zTrix/cpu20day/trunk/doc/IF.pdf

F

clk

rst

stall

i_instruction(15:0) o_instruction(15:0)
