zTrix/cpu20day/trunk/doc/schematic.pdf

1

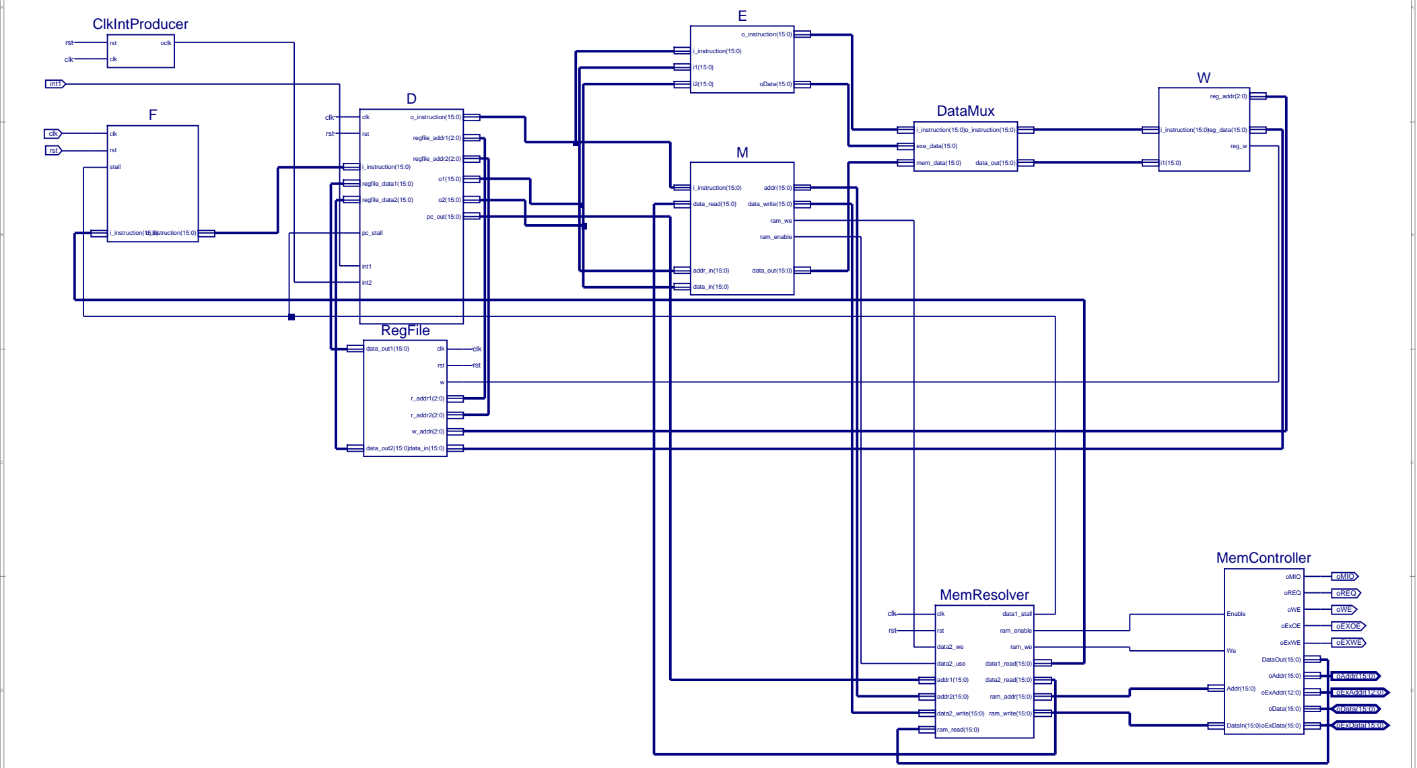
[picture p8: figure]
clk; RegFile; rst; r_addr1(2:0); r_addr2(2:0); w_addr(2:0); data_in(15:0); data_out1(15:0); data_out2(15:0); MemController; Enable; Addr(15:0); DataIn(15:0); oData(15:0); oExData(15:0); oMIO; oREQ; oWE; oExOE; oExWE; DataOut(15:0); oAddr(15:0); oExAddr(12:0); oEXOE; oEXWE; MemResolver; data2_we; data2_use; addr1(15:0); addr2(15:0); data2_write(15:0); ram_read(15:0); data1_stall; ram_enable; ram_we; data1_read(15:0); data2_read(15:0); ram_addr(15:0); ram_write(15:0); i_instruction(15:0); o_instruction(15:0); addr_in(15:0); data_read(15:0); data_out(15:0); addr(15:0); data_write(15:0); DataMux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
# DebugOutput

input1(15:0)

input2(15:0)

input3(15:0)

output1(15:0)

output2(15:0)

output3(15:0)

Debug1(15:0)

Debug2(15:0)

Debug3(15:0)

id_instr(15:0)

id_o1(15:0)

id_o2(15:0)
