zTrix/cpu20day/trunk/doc/clkintproducer.pdf

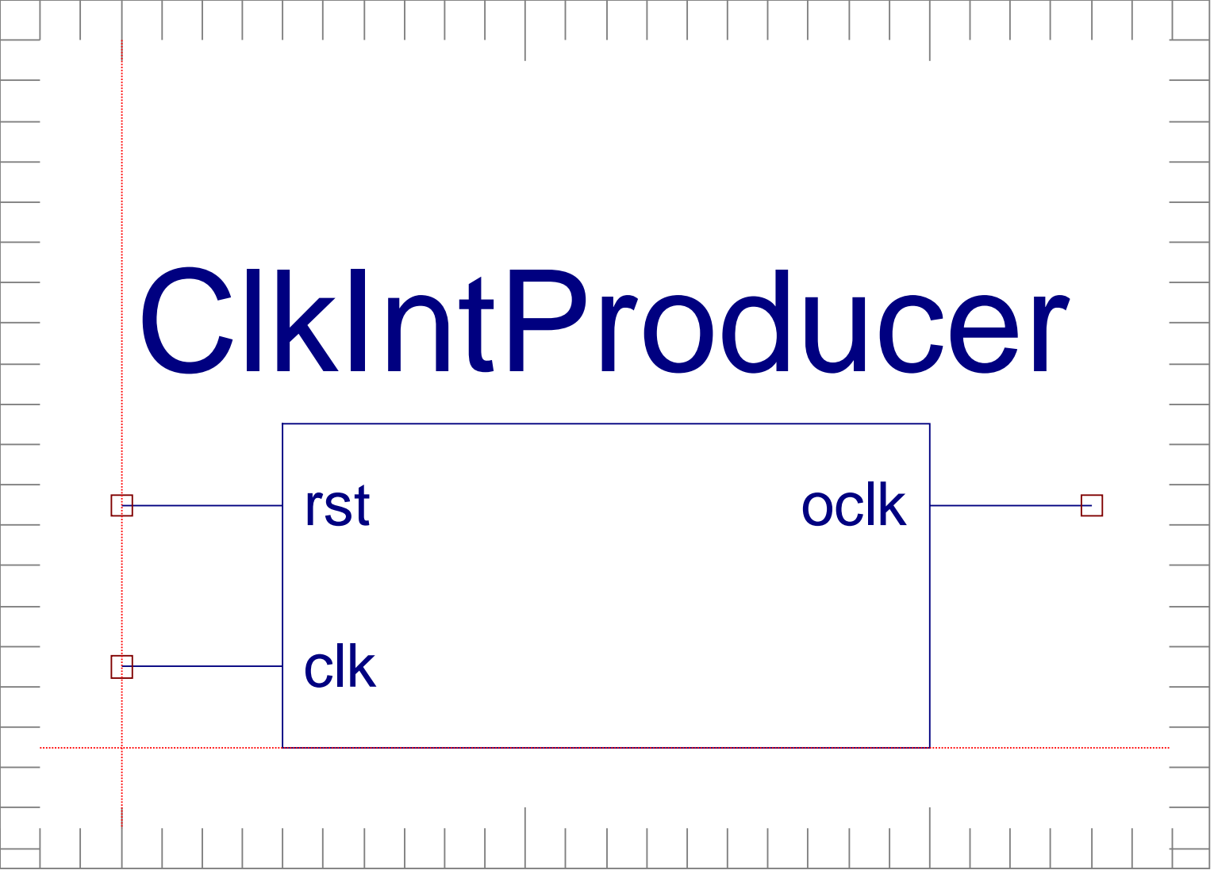
[picture p9: figure]
ClkIntProducer; rst; clk; oclk
