zTrix/cpu20day/trunk/doc/datamux.pdf

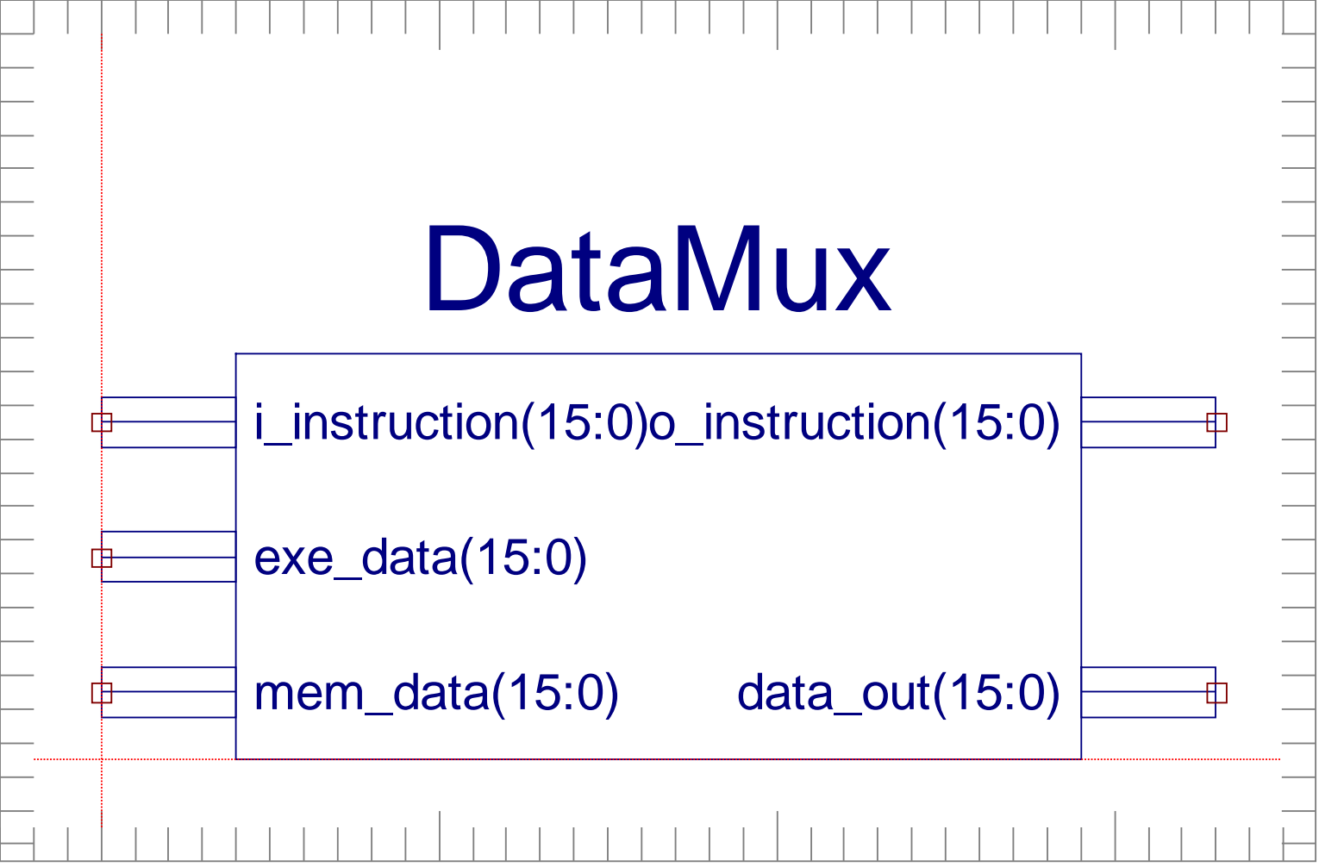
[picture p10: figure]
DataMux; i_instruction(15:0); exe_data(15:0); mem_data(15:0); o_instruction(15:0); data_out(15:0)
