zTrix/cpu20day/trunk/doc/EXE.pdf

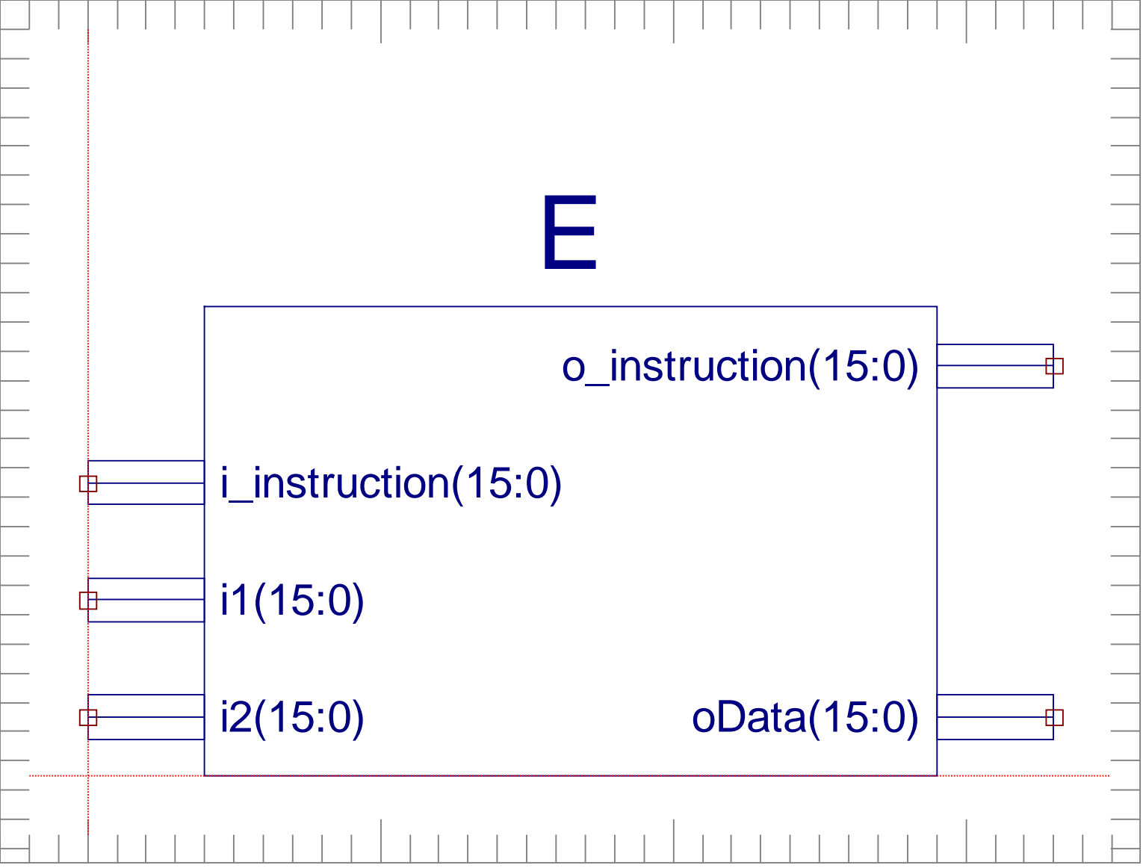
[picture p11: figure]
i_instruction(15:0); o_instruction(15:0); oData(15:0)
