zTrix/cpu20day/trunk/doc/ID.pdf

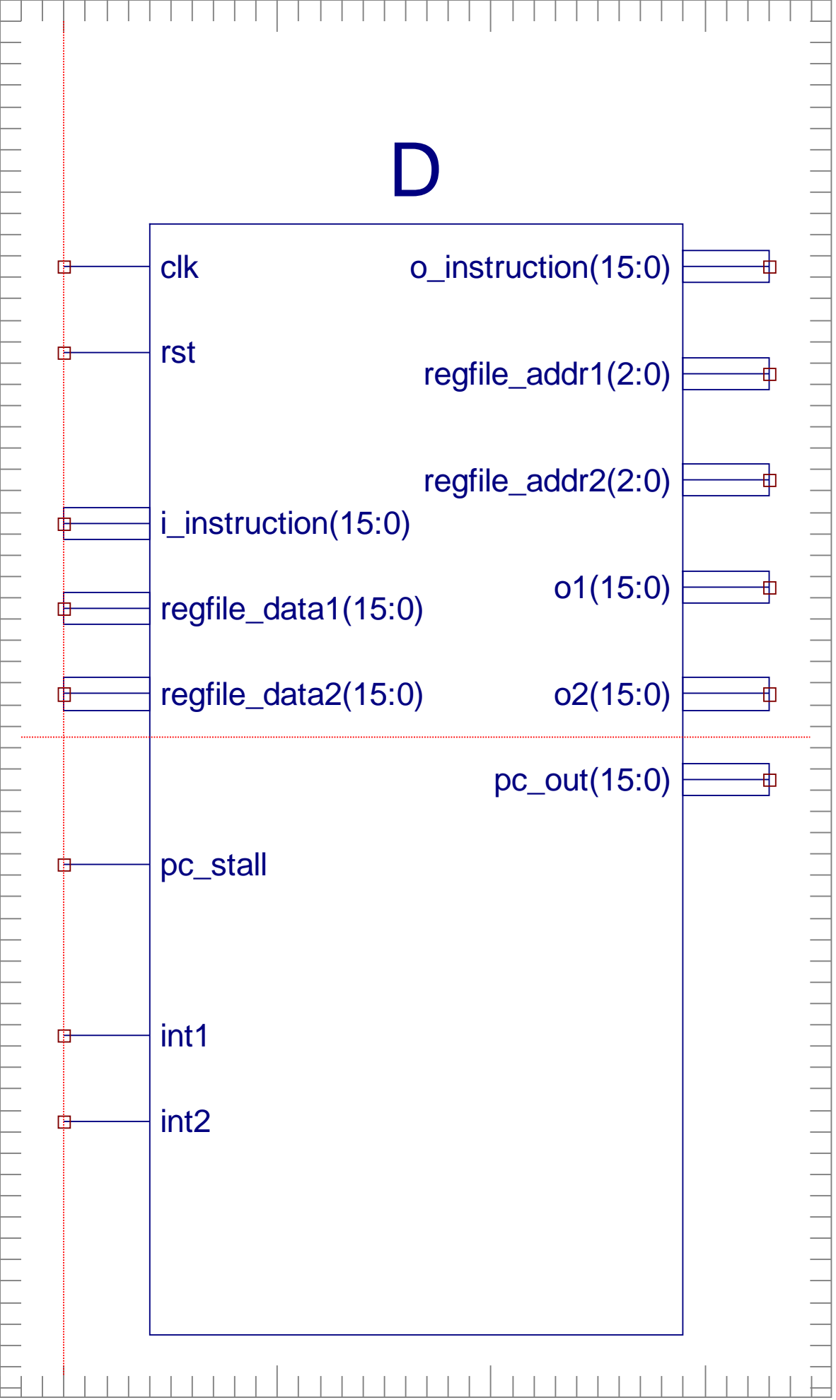
[picture p12: figure]
clk; rst; pc_stall; i_instruction(15:0); regfile_data1(15:0); regfile_data2(15:0); o_instruction(15:0); regfile_addr1(2:0); regfile_addr2(2:0); pc_out(15:0); int1; int2
