zTrix/cpu20day/trunk/doc/MEM.pdf

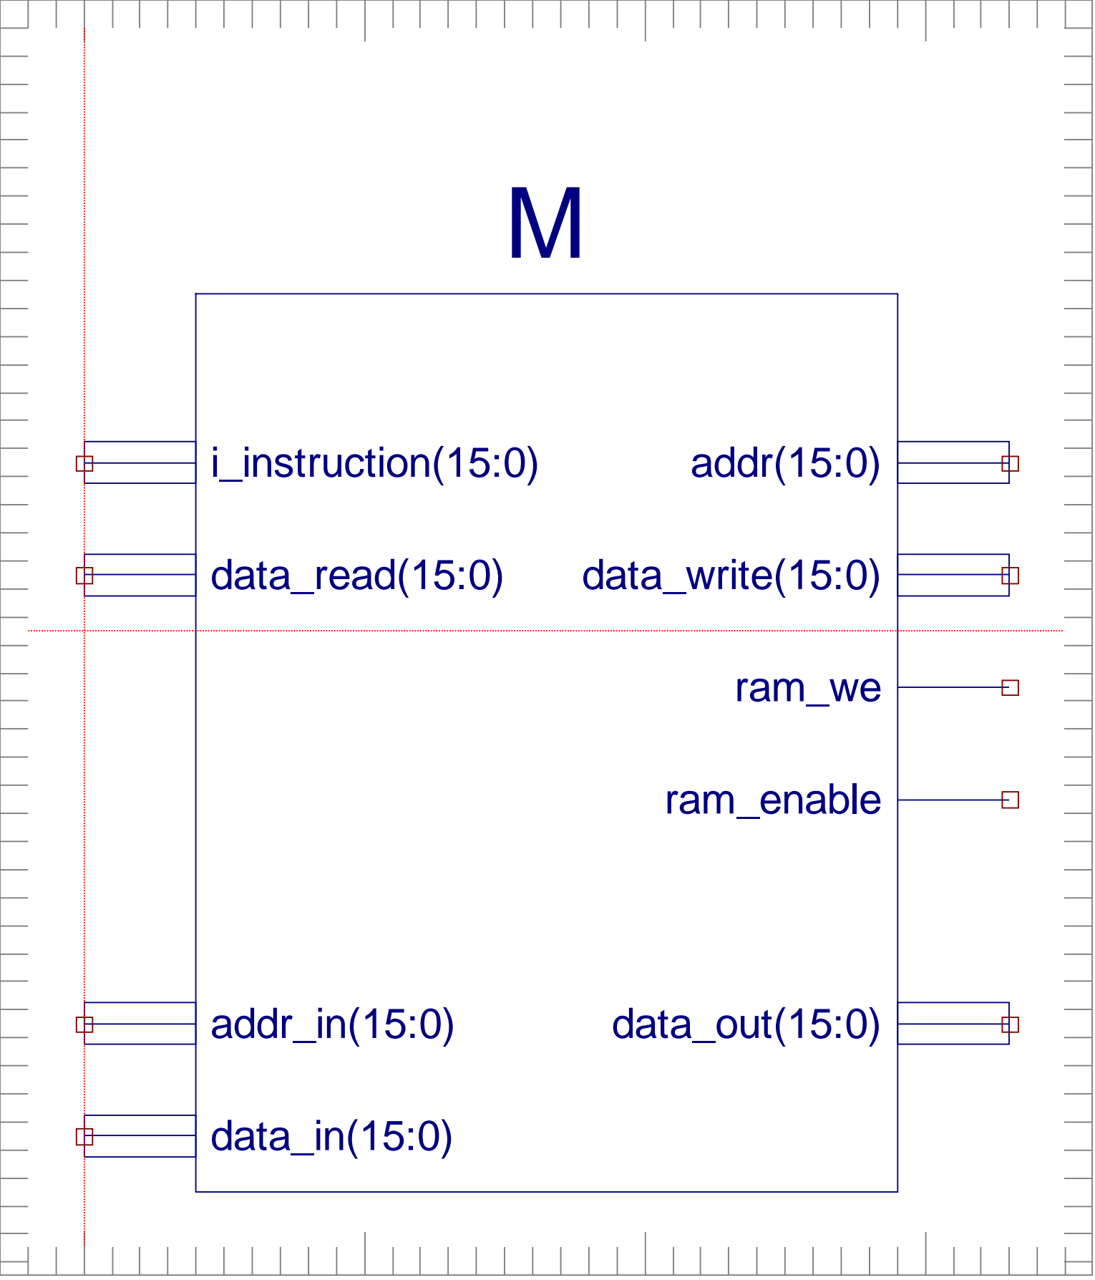
[picture p13: figure]
i_instruction(15:0); addr_in(15:0); data_in(15:0); data_read(15:0); ram_we; ram_enable; data_out(15:0); addr(15:0); data_write(15:0)
