zTrix/cpu20day/trunk/doc/rtl.pdf

# Block=CPU Sheet=1 Page=1

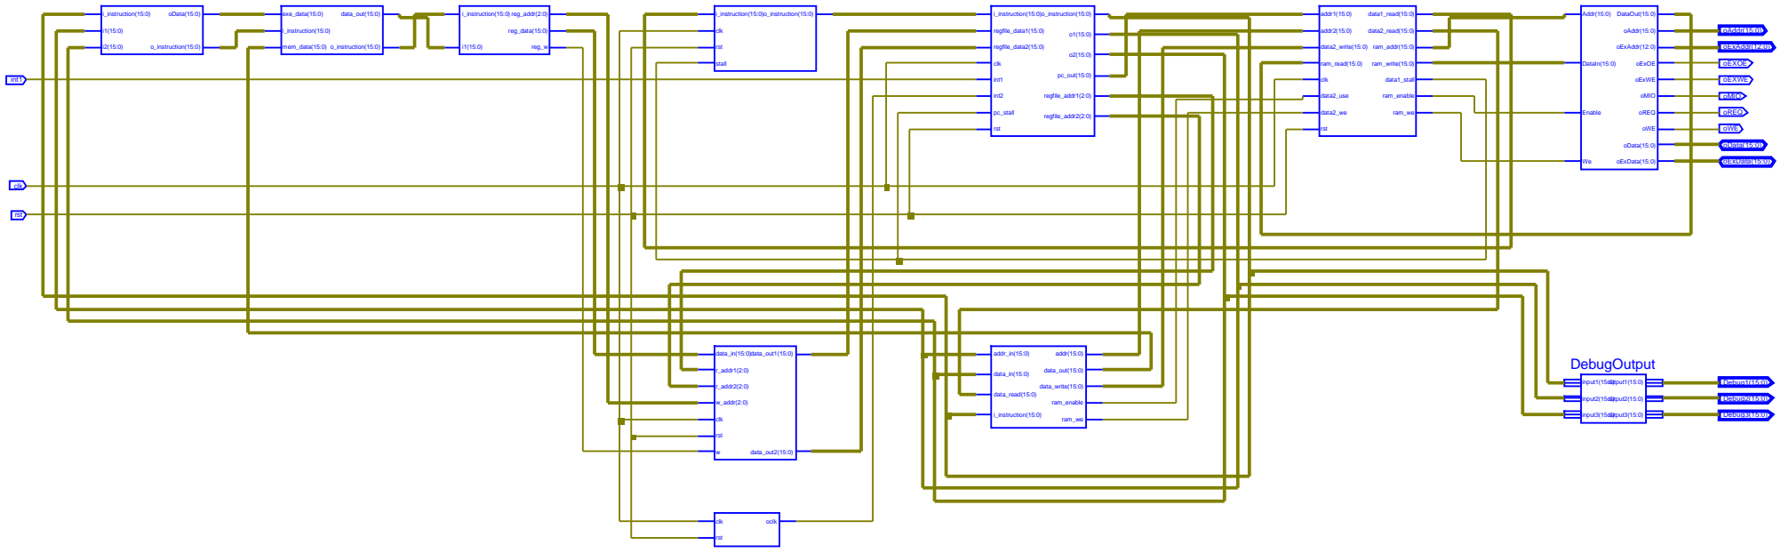
[picture p14: figure]
i_instruction(15:0); oData(15:0); o_instruction(15:0); exe_data(15:0); mem_data(15:0); data_out(15:0); reg_addr(2:0); reg_data(15:0); reg_w; clk; rst; stall; data_in(15:0); r_addr1(2:0); r_addr2(2:0); w_addr(2:0); data_out1(15:0); data_out2(15:0); oclk; regfile_data1(15:0); regfile_data2(15:0); int1; int2; pc_stall; pc_out(15:0); regfile_addr1(2:0); regfile_addr2(2:0); addr_in(15:0); data_read(15:0); addr(15:0); data_write(15:0); ram_enable; ram_we; addr1(15:0); addr2(15:0); data2_write(15:0); ram_read(15:0); data2_use; data2_we; data1_read(15:0); data2_read(15:0); ram_addr(15:0)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
