zTrix/cpu20day/trunk/doc/WB.pdf

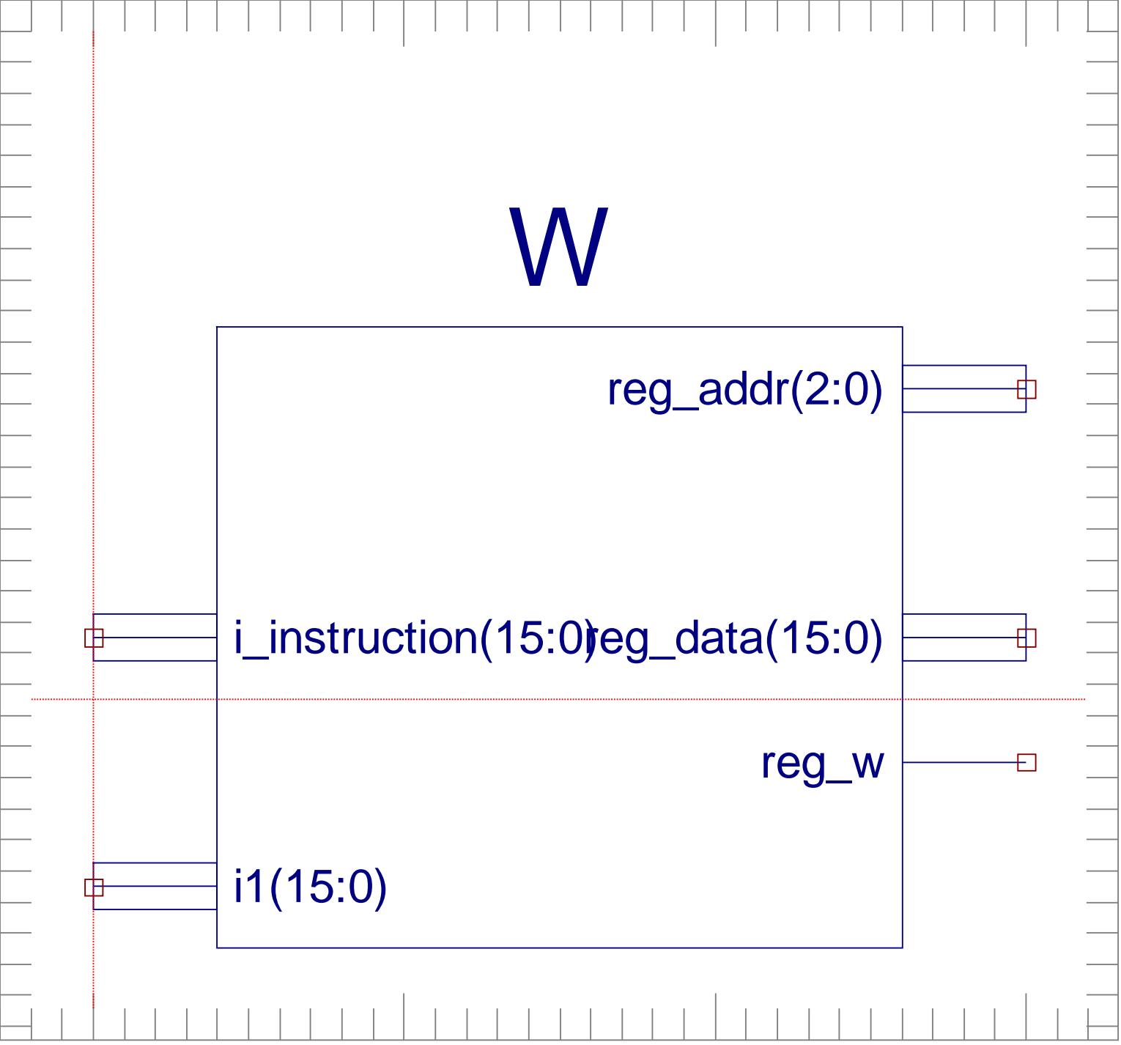
[picture p15: figure]
i_instruction(15:0); reg_w; reg_addr(2:0); reg_data(15:0)
