zTrix/cpu20day/trunk/doc/summary.png

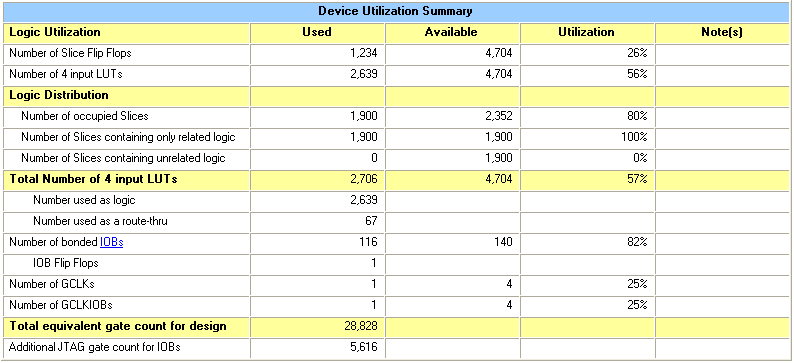
trunk/doc/summary.png
