zTrix/cpu20day/trunk/doc/wzw.gif

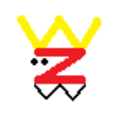
trunk/doc/wzw.gif
