zTrix/cpu20day/trunk/doc/WB_order.txt

WriteToRx:

21 ADDIU 
22 ADDSP3
2 AND
28 LI
29 LW_SP
30 MFIH
31 MFPC
5 MOVE
32 MTIH
6 NEG
7 NOT
8 OR
9 SLL
13 SRA
15 SRL
18 XOR

WriteToRy

1 ADDIU3
4 LW
10 SLLV
14 SRAV
16 SRLV

WriteToRz

19 ADDU

20 SUBU

WriteToPC

23 BEQZ
24 BNEZ
39 BTEQZ
40 BTNEZ
27 JR
42 JRRA
43 B

WriteToT

3 CMP
25 CMPI
11 SLT
12 SLTU
34 SLTUI

WriteToPC+RA

26 JALR

WriteToMem

17 SW
38 SW_RS
35 SW_SP
