zTrix/cpu20day/trunk/doc/framework.pdf

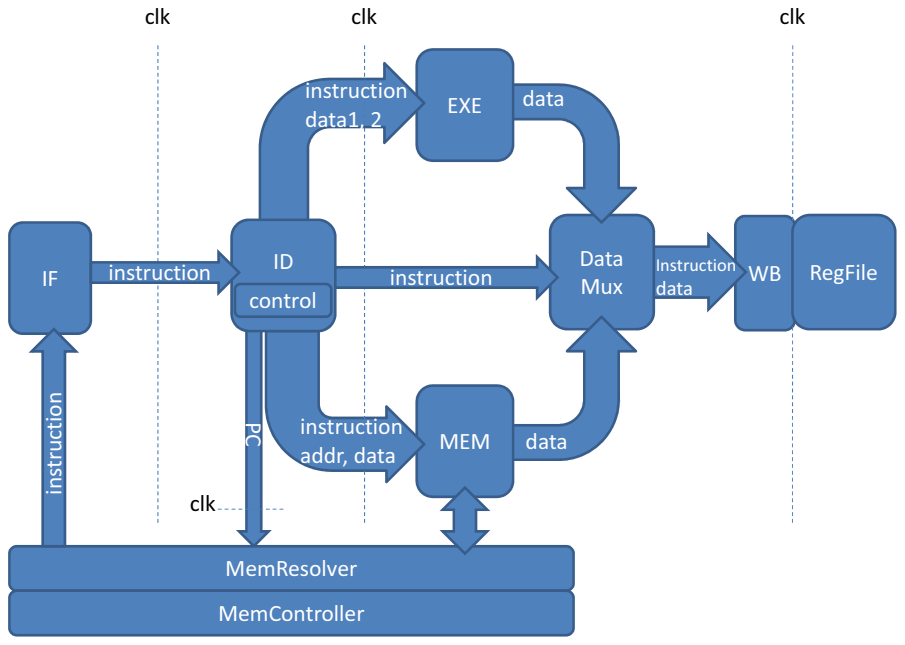
[picture p18: page 1]
Data Mux; EXE; MEM; clk; RegFile; MemResolver; instruction; ID instruction; MemController; instruction data1, 2; instruction addr, data; data; control; Instruction
